yashwanth7007/Balance_Bot/README.md

# Balance_Bot
Two wheel balance bot
by 
Yashwanth,
Lukman A R,
Niranjangupta,
https://www.youtube.com/watch?v=Q34HDC4lGTw&feature=youtu.be

Header usage is not done as it should be done for c/c++ based project. Logic needs to 
be taken out of header files.
